mcer12/Flippity210/resources/boards.jpg

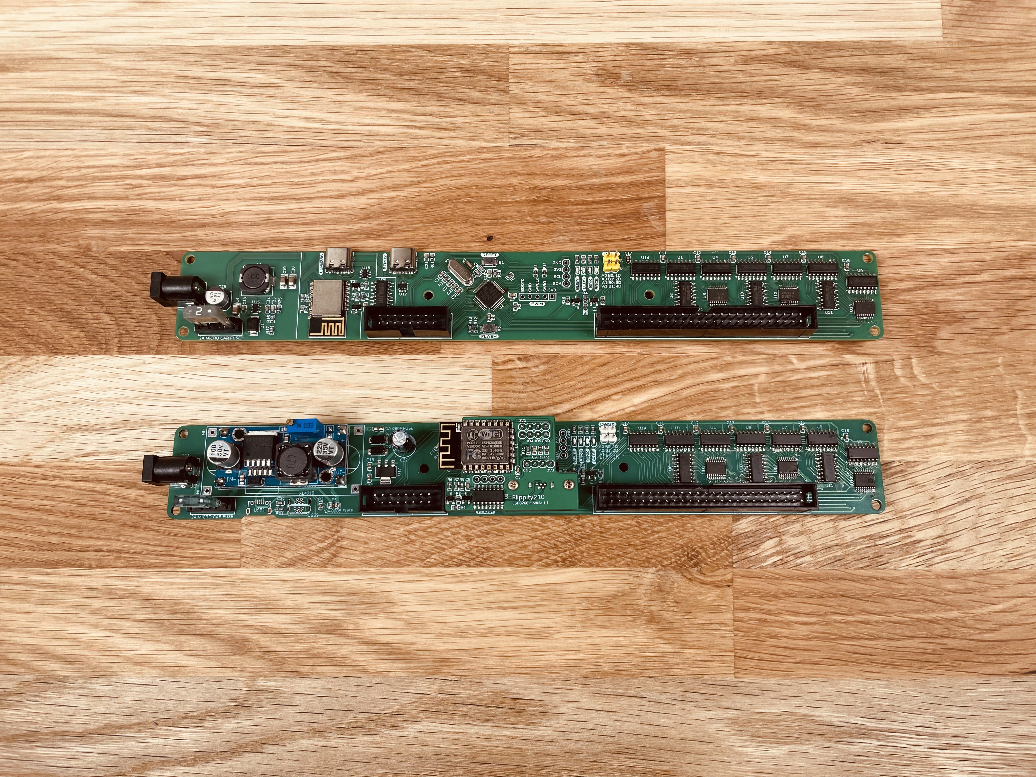
resources/boards.jpg
