mcer12/Flippity210/README.md

# Flippity210
Control board and library for BUSE BS210 flip dot displays. It also works with older BS110 (non-led) variant, just bear in mind that BS110 is a different form factor so it won't fit in the 3D printed enclosure!

https://github.com/user-attachments/assets/d0198746-1350-4b9b-a5e5-f4e7e80c436d

- This project enables you to control these beautiful flip-dot displays via I2C the same way you use I2C oled displays for example. 
- The library supports Adafruit GFX which enables you to draw fonts and geometry.
- Custom PCB and schematic is provided in the repository and replaces the original control board (it is not the same form factor!).
- The board has two MCUs - STM32 to control the display itself and provide a simple I2C interface to communicate with, and optional ESP8266 to control the STM32 via I2C on high level.
- I2C header if you don't want o use built-in ESP8266 and/or want to add other I2C devices.
- Supports up to 4 daisy-chained displays with the default firmware, up to 8 in theory with SW changes.

## What's needed to make it work:
- Assembled custom board (see repository wiki page and schematic notes)
- 24V adapter (see repository wiki)
- ST-Link and STM Cube Programmer to flash STM32 firmware to the board
- Arduino IDE or PlatformIO to flash the integrated ESP8266 or you can connect to the board via I2C from Raspberry or whatever else.
- See project wiki https://github.com/mcer12/Flippity210/wiki

## Status
- PCB: Finished! Latest V3X (and V3) revision has integrated ESP8266 so it doesn't require the daughter board anymore.
- Library: Finished
- 3D printed enclosure: https://www.printables.com/model/468031-flippity210-flip-dot-display-case

  

Photo 29 03 2025, 18 18 272
