mcer12/Flippity210/pcb/Flippity210_V3_schematic.pdf

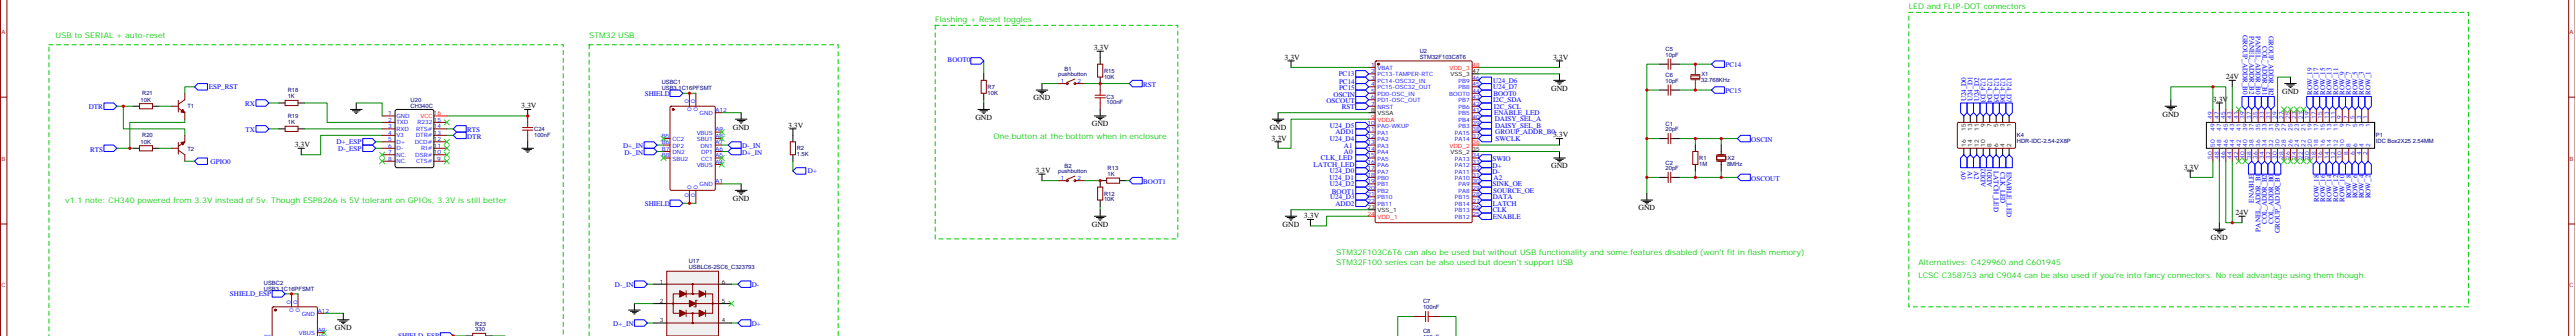
[picture p4: figure]
IDC Box2X25 2.54MM; HDR-IDC-2.54-2X8P; ADD2; ADD1; STM32F103C8T6; VBAT; PC13-TAMPER-RTC; PC14-OSC32_IN; PC15-OSC32_OUT; PD0-OSC_IN; PD1-OSC_OUT; NRST; VSSA; VDDA; PA0-WKUP; VSS_1; VDD_1; VSS_2; VDD_2; BOOT0; VSS_3; VDD_3; GND; GROUP_ADDR_B0 PANEL_ADDR_B2; PANEL_ADDR_B0 PANEL_ADDR_B1; ENABLE; COL_ADDR_B1; GROUP_ADDR_B2; COL_ADDR_B2; COL_ADDR_B0; GROUP_ADDR_B1; ROW_19; ROW_17; ROW_15; ROW_13; ROW_11 ROW_9; ROW_7; ROW_5; ROW_3; ROW_1; ROW_18; ROW_16; ROW_14; ROW_12; ROW_10 ROW_8; ROW_6; ROW_4; ROW_2; 32.768KHz; OSCOUT; OSCIN; OSCIN OSCOUT; SWIO; SWCLK; BOOT1; RST; LATCH_LED CLK_LED; DATA; CLK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
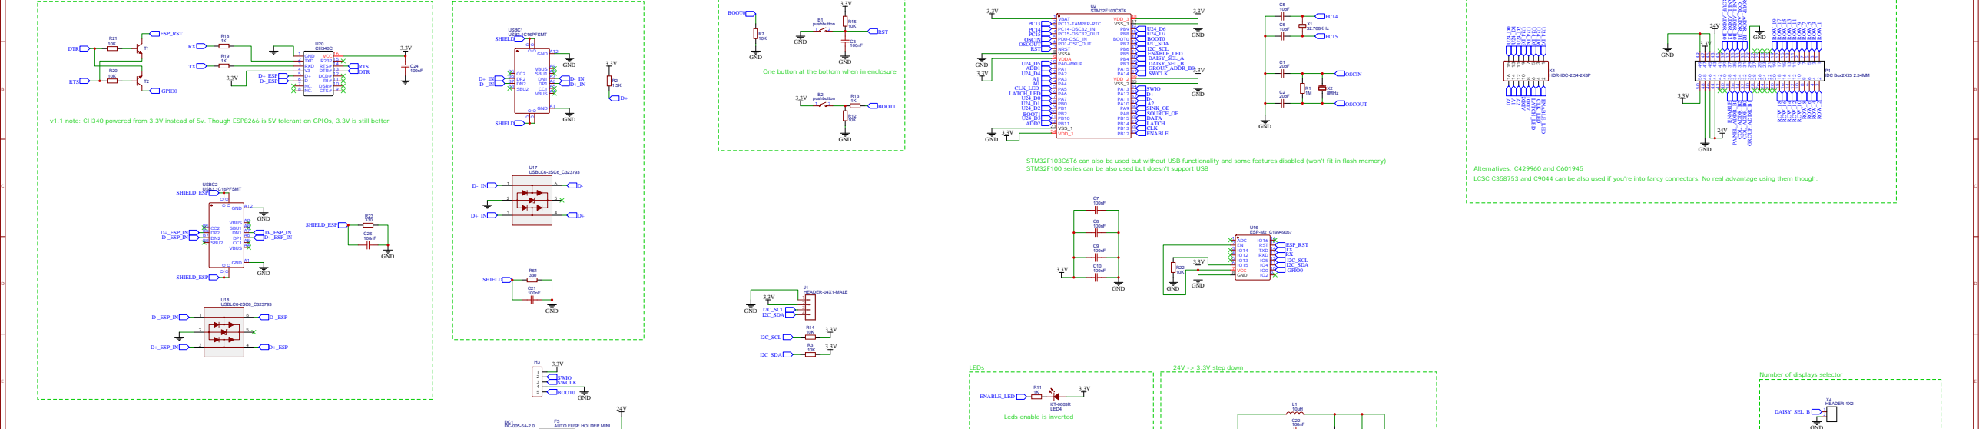
[picture p5: figure]
GND; SWCLK; SWIO; ENABLE_LED; KT-0603R LED4; BOOT0; HEADER-1X2; SHIELD; DAISY_SEL_B; Leds enable is inverted; LEDs; I2C_SCL I2C_SDA; HEADER-04X1-MALE; I2C_SDA; I2C_SCL; Number of displays selector; 24V -> 3.3V step down; ESP-M2_C19949057; ADC; VCC; RXD; TXD; RST; GPIO0; ESP_RST; GND GND; USBLC6-2SC6_C323793; D+_ESP_IN; D+_ESP; D-_ESP_IN; D-_ESP; SHIELD_ESP; CC2 B5 DP2 B6 DN2 B7 SBU2 B8; GND A1

F | F
G | G
H | H
I | I
J | J
K | K

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
TITLE:
Flippity Control Board | REV: 2.1
Date: | 2023-04-04

Sheet: 1/1
Drawn By: NiceThings

Company:

9 10 10 11 11 12 12 13 13 14 14 15 15 16 16 17 17 18 18 19 19 20 20 21 21 22 22 23 23 24 24 25 25 26 26 27 27 28 28 29 29 30 30 31 31 32 32 33 33 34 34 35 35 36 36 37 37 38 38 39 39 40 40 41 41 42 42 43 43 44 44 45 45 46 46 47 47 48 48 49 49 50 50

74HC595D,118

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
8 Q7S

9 MR# 10 SHCP 11 STCP 12 OE# 13 DS 14 Q0 15 VCC 16

74HC595D,118

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
8 Q7S

9 MR# 10 SHCP 11 STCP 12 OE# 13 DS 14 Q0 15 VCC 16

ULN2003ADR

U6

1B

1 2B

2 3B

3 4B

4 5B

5 6B

6 7B

7

E

8 COM

9

7C 10

6C 11

5C 12

4C 13

3C 14

2C 15

1C 16

74HC595D,118

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
8 Q7S

9 MR# 10 SHCP 11 STCP 12 OE# 13 DS 14 Q0 15 VCC 16

74HC595D,118

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
8 Q7S

9 MR# 10 SHCP 11 STCP 12 OE# 13 DS 14 Q0 15 VCC 16

74HC595D,118

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
8 Q7S

9 MR# 10 SHCP 11 STCP 12 OE# 13 DS 14 Q0 15 VCC 16

ULN2003ADR

U10

1B

1 2B

2 3B

3 4B

4 5B

5 6B

6 7B

7

E

8 COM

9

7C 10

6C 11

5C 12

4C 13

3C 14

2C 15

1C 16

ULN2003ADR

U11

1B

1 2B

2 3B

3 4B

4 5B

5 6B

6 7B

7

E

8 COM

9

7C 10

6C 11

5C 12

4C 13

3C 14

2C 15

1C 16

ROW_19

ROW_18
ROW_17

ROW_16
ROW_15

74HC595D,118

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
8 Q7S

# 9 MR# 10 SHCP 11 STCP 12 OE# 13 DS 14 Q0 15 VCC 16 ROW_19 ROW_18 ROW_17 ROW_16 ROW_15

ROW_4

TBD62783AFNG,EL

U3

I1

1 I2

2 I3

3 I4

4 I5

5 I6

6 I7

7 I8

8 VCC

9 GND 10

O8 11

O7 12

O6 13

O5 14

O4 15

O3 16

O2 17

O1 18

TBD62783AFNG,EL

U12

I1

1 I2

2 I3

3 I4

4 I5

5 I6

6 I7

7 I8

8 VCC

9 GND 10

O8 11

O7 12

O6 13

O5 14

O4 15

O3 16

O2 17

O1 18

TBD62783AFNG,EL

U13

I1

1 I2

2 I3

3 I4

4 I5

5 I6

6 I7

7 I8

8 VCC

9 GND 10

O8 11

O7 12

O6 13

O5 14

O4 15

O3 16

O2 17

O1 18

74HC595D,118

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
8 Q7S

9 MR# 10 SHCP 11 STCP 12 OE# 13 DS 14 Q0 15 VCC 16

KT-0603R

LED1

PC13

GND

DC-005-5A-2.0
1

2

3
3.3V

SINK_OE
BSS138

F8

GND GND

3.3V

SINK_OE_INVERTED | SOURCE_OE_INVERTED

3.3V

GND GND

BSS138

SOURCE_OE | F1

KT-0603R

LED2

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
ROW_11

GROUP_ADDR_B2

GROUP_ADDR_B1
COL_ADDR_B2
COL_ADDR_B1

COL_ADDR_B0

3.3V

GND

3.3V

GND

3.3V

GND

3.3V

GND

3.3V

GND

3.3V

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
3.3V

100nF

C11

100nF

C12

100nF

C13

100nF

C14

GND

100nF

C15

100nF

C16

100nF

C17

3.3V

GND

SINK_OE_INVERTED

SOURCE_OE_INVERTED
SINK_OE_INVERTED

SINK_OE_INVERTED

SOURCE_OE_INVERTED
SOURCE_OE_INVERTED

ROW_9

ROW_14
ROW_13

ROW_9

ROW_14
ROW_13

ROW_12
ROW_11

ROW_10

ROW_12
ROW_8

ROW_10
ROW_8

ROW_5

ROW_3

ROW_1
ROW_2

ROW_6

ROW_7

ROW_5

ROW_3

ROW_1
ROW_4

ROW_2

ROW_6

ROW_7

GND

3.3V
DATA

LATCH

CLK

LATCH

CLK

LATCH

CLK

LATCH

CLK

LATCH

CLK

LATCH

CLK

LATCH

CLK

3.3V | 3.3V
3.3V | 3.3V
3.3V | 3.3V

DATA2
DATA3

DATA4

DATA5

DATA6
DATA7

DATA5

DATA6
DATA7
DATA4

DATA3

DATA2

U6_7B
U6_6B

U6_5B

U6_1B

U6_2B

U6_3B

U6_4B

U5_7B

U5_6B

U5_5B

U5_1B

U5_2B
U5_3B

U5_4B

U8_7B

U8_6B

U8_5B

U8_1B

U8_2B

U8_3B

U8_4B

U6_7B

U6_6B

U6_5B

U6_4B

U6_3B

U6_2B

U6_1B

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
U5_7B

U5_6B

U5_5B

U5_4B

U5_3B
U5_2B

U5_1B

U8_7B

U8_6B

U8_5B

U8_4B

U8_3B

U8_2B

U8_1B

AUTO FUSE HOLDER MINI
2 | 1

HEADER-1X2

X3

1
2

GND

GND

1K

R6

PANEL_ADDR_B1

PANEL_ADDR_B0 PANEL_ADDR_B2

DAISY_SEL_A

SOURCE_OE_INVERTED

3.3V

KT-0603R

LED3

1K

R10
SINK_OE_INVERTED

3.3V

Sink + Source drivers

Older TD62783AFNG can be used (available on aliexpress)
HT62783ARTZ (lcsc: C5143073) can also be used BUT but has two extra pins so check the datasheet! Those pins are disconnected and will just lay on the solder mask

This part is critical, controls the electromagnets with high current surges, any solder bridge or interminnent connection can cause magic smoke!

STM32F103C6T6 can also be used but without USB functionality and some features disabled (won't fit in flash memory) STM32F100 series can be also used but doesn't support USB
LCSC C358753 and C9044 can be also used if you're into fancy connectors. No real advantage using them though.

For micro fuse use C843270 holder

Cheaper chinese 595 shift registers like C79097 also work perfectly fine

One button at the bottom when in enclosure

Use jumpers to switch number of displays in daisy-chain generic 2.54mm jumper will work, ie C5274534

1A fuse recommended, 2A max (C151091)

TPS54202DDCR

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
BOOT

6

10uF

C4
100nF

C18
22uF

C19
22uF

C20

GND

GND

GND

56pF

C23

3.3V

10K

R16

12k

R17

100K

R25

24V

SMBJ26A_C315992

D1

GND

v1.1 note: CH340 powered from 3.3V instead of 5v. Though ESP8266 is 5V tolerant on GPIOs, 3.3V is still better

VBUS A4 CC1 A5 DP1 A6 DN1 A7 SBU1 A8 VBUS A9

GND

100uF

C25
