mcer12/Flippity210/pcb/Flippity210_v2.1_schematic.pdf

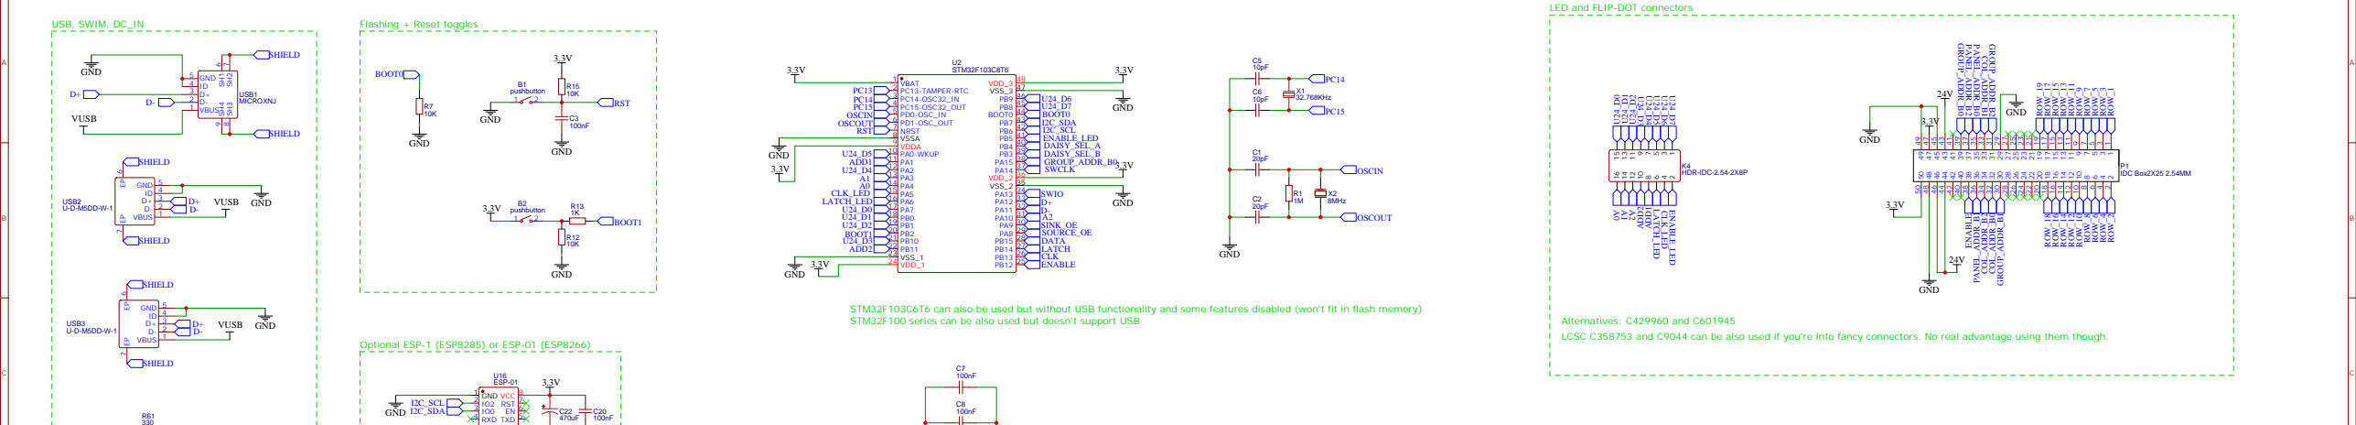
[picture p6: figure]
IDC Box2X25 2.54MM; HDR-IDC-2.54-2X8P; ADD2; ADD1; STM32F103C8T6; VBAT; PC13-TAMPER-RTC; PC14-OSC32_IN; PC15-OSC32_OUT; PD0-OSC_IN; PD1-OSC_OUT; NRST; VSSA; VDDA; PA0-WKUP; VSS_1; VDD_1; VSS_2; VDD_2; BOOT0; VSS_3; VDD_3; GND; GROUP_ADDR_B0 PANEL_ADDR_B2; PANEL_ADDR_B0 PANEL_ADDR_B1; ENABLE; COL_ADDR_B1; GROUP_ADDR_B2; COL_ADDR_B2; COL_ADDR_B0; GROUP_ADDR_B1; ROW_19; ROW_17; ROW_15; ROW_13; ROW_11 ROW_9; ROW_7; ROW_5; ROW_3; ROW_1; ROW_18; ROW_16; ROW_14; ROW_12; ROW_10 ROW_8; ROW_6; ROW_4; ROW_2; 32.768KHz; OSCOUT; OSCIN; MICROXNJ; USB1; 6 GND 5 ID 4 D+ 3 D- 2 VBUS 1; OSCIN OSCOUT; SWIO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
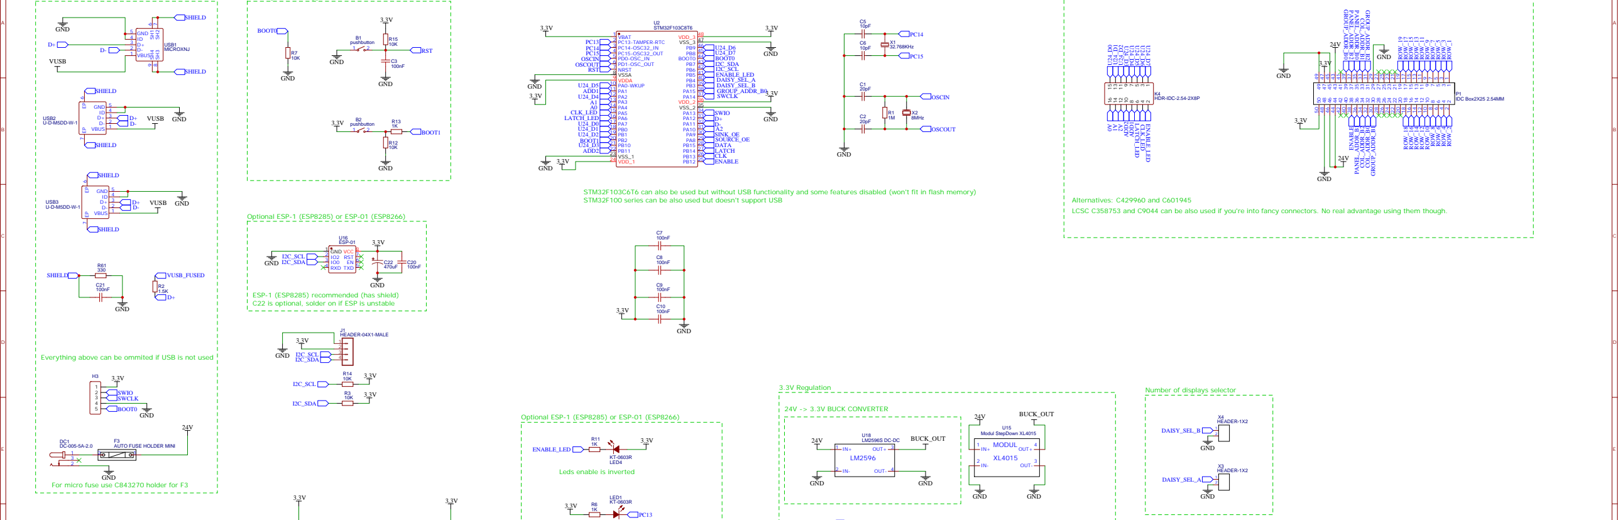
[picture p7: figure]
GND; SWCLK; SWIO; LED1; OUT+; OUT-; BUCK_OUT; 24V -> 3.3V BUCK CONVERTER; ENABLE_LED; KT-0603R LED4; 3.3V Regulation; BOOT0; AUTO FUSE HOLDER MINI; Modul StepDown XL4015; MODUL; TXD 5; RXD 4; ESP-1 (ESP8285) recommended (has shield); HEADER-1X2; SHIELD; DAISY_SEL_A; DAISY_SEL_B; VUSB_FUSED; Leds enable is inverted; I2C_SCL I2C_SDA; HEADER-04X1-MALE; I2C_SDA; I2C_SCL; Number of displays selector
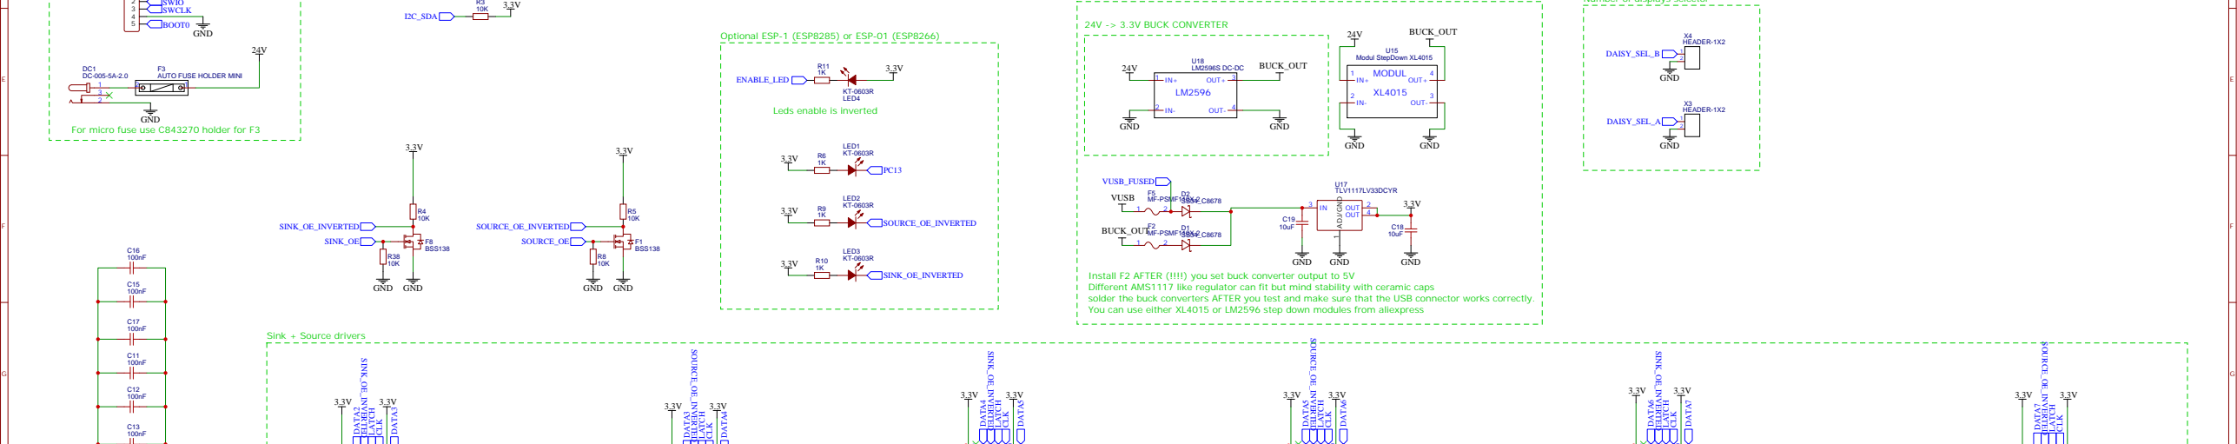
[picture p8: figure]
SINK_OE; BSS138; GND GND; SINK_OE_INVERTED; SOURCE_OE_INVERTED; SOURCE_OE; LED2; GND; VUSB; BUCK_OUT; MF-PSMF110X-2; LATCH; CLK; DATA2; DATA3; DATA4; DATA5; DATA6; DATA7; VUSB_FUSED; TLV1117LV33DCYR; U17ADJ/GND; OUT; LED3; Sink + Source drivers

H | H
I | I
J | J
K | K

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
TITLE:
Flipity V2 | REV: 1.0
Date: | 2020-11-14

Sheet: 1/1
Drawn By: NiceThings

Company:

9 10 10 11 11 12 12 13 13 14 14 15 15 16 16 17 17 18 18 19 19 20 20 21 21 22 22 23 23 24 24 25 25 26 26 27 27 28 28 29 29 30 30 31 31 32 32 33 33 34 34 35 35 36 36 37 37 38 38 39 39 40 40 41 41 42 42 43 43 44 44 45 45 46 46 47 47 48 48 49 49 50 50

74HC595D,118

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
8 Q7S

9 MR# 10 SHCP 11 STCP 12 OE# 13 DS 14 Q0 15 VCC 16

74HC595D,118

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
8 Q7S

9 MR# 10 SHCP 11 STCP 12 OE# 13 DS 14 Q0 15 VCC 16

ULN2003ADR

U6

1B

1 2B

2 3B

3 4B

4 5B

5 6B

6 7B

7

E

8 COM

9

7C 10

6C 11

5C 12

4C 13

3C 14

2C 15

1C 16

74HC595D,118

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
8 Q7S

9 MR# 10 SHCP 11 STCP 12 OE# 13 DS 14 Q0 15 VCC 16

74HC595D,118

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
8 Q7S

9 MR# 10 SHCP 11 STCP 12 OE# 13 DS 14 Q0 15 VCC 16

74HC595D,118

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
8 Q7S

9 MR# 10 SHCP 11 STCP 12 OE# 13 DS 14 Q0 15 VCC 16

ULN2003ADR

U10

1B

1 2B

2 3B

3 4B

4 5B

5 6B

6 7B

7

E

8 COM

9

7C 10

6C 11

5C 12

4C 13

3C 14

2C 15

1C 16

ULN2003ADR

U11

1B

1 2B

2 3B

3 4B

4 5B

5 6B

6 7B

7

E

8 COM

9

7C 10

6C 11

5C 12

4C 13

3C 14

2C 15

1C 16

ROW_19

ROW_18
ROW_17

ROW_16
ROW_15

74HC595D,118

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
8 Q7S

# 9 MR# 10 SHCP 11 STCP 12 OE# 13 DS 14 Q0 15 VCC 16 ROW_19 ROW_18 ROW_17 ROW_16 ROW_15

ROW_4

TBD62783AFNG,EL

U3

I1

1 I2

2 I3

3 I4

4 I5

5 I6

6 I7

7 I8

8 VCC

9 GND 10

O8 11

O7 12

O6 13

O5 14

O4 15

O3 16

O2 17

O1 18

TBD62783AFNG,EL

U12

I1

1 I2

2 I3

3 I4

4 I5

5 I6

6 I7

7 I8

8 VCC

9 GND 10

O8 11

O7 12

O6 13

O5 14

O4 15

O3 16

O2 17

O1 18

TBD62783AFNG,EL

U13

I1

1 I2

2 I3

3 I4

4 I5

5 I6

6 I7

7 I8

8 VCC

9 GND 10

O8 11

O7 12

O6 13

O5 14

O4 15

O3 16

O2 17

O1 18

74HC595D,118

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
8 Q7S

9 MR# 10 SHCP 11 STCP 12 OE# 13 DS 14 Q0 15 VCC 16

ROW_11

GROUP_ADDR_B2

GROUP_ADDR_B1
COL_ADDR_B2
COL_ADDR_B1

COL_ADDR_B0

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
3.3V
100nF

C14

GND

3.3V

GND

ROW_9

ROW_14
ROW_13

ROW_9

ROW_14
ROW_13

ROW_12
ROW_11

ROW_10

ROW_12
ROW_8

ROW_10
ROW_8

ROW_5

ROW_3

ROW_1
ROW_2

ROW_6

ROW_7

ROW_5

ROW_3

ROW_1
ROW_4

ROW_2

ROW_6

ROW_7

Different AMS1117 like regulator can fit but mind stability with ceramic caps

GND

3.3V
DATA

LATCH

CLK

DATA2

U6_7B
U6_6B

U6_5B

U6_1B

U6_2B

U6_3B

U6_4B

U5_7B

U5_6B

U5_5B

U5_1B

U5_2B
U5_3B

U5_4B

U8_7B

U8_6B

U8_5B

U8_1B

U8_2B

U8_3B

U8_4B

U6_7B

U6_6B

U6_5B

U6_4B

U6_3B

U6_2B

U6_1B

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
U5_7B

U5_6B

U5_5B

U5_4B

U5_3B
U5_2B

U5_1B

U8_7B

U8_6B

U8_5B

U8_4B

U8_3B

U8_2B

U8_1B

Optional ESP-1 (ESP8285) or ESP-01 (ESP8266)

PANEL_ADDR_B1

PANEL_ADDR_B0 PANEL_ADDR_B2

Optional ESP-1 (ESP8285) or ESP-01 (ESP8266)

C22 is optional, solder on if ESP is unstable

Install F2 AFTER (!!!!) you set buck converter output to 5V

Everything above can be ommited if USB is not used

Older TD62783AFNG can be used (available on aliexpress)
HT62783ARTZ (lcsc: C5143073) can also be used BUT but has two extra pins so check the datasheet! Those pins are disconnected and will just lay on the solder mask

This part is critical, controls the electromagnets with high current surges, any solder bridge or interminnent connection can cause magic smoke!

solder the buck converters AFTER you test and make sure that the USB connector works correctly.

STM32F103C6T6 can also be used but without USB functionality and some features disabled (won't fit in flash memory) STM32F100 series can be also used but doesn't support USB

You can use either XL4015 or LM2596 step down modules from aliexpress

LCSC C358753 and C9044 can be also used if you're into fancy connectors. No real advantage using them though.

For micro fuse use C843270 holder for F3

Cheaper chinese 595 shift registers like C79097 also work perfectly fine
