mcer12/Flippity210/pcb/Flippity210_v2.1_BOM.csv

ID | Name | Designator | Footprint | Quantity | Manufacturer Part | Manufacturer | Supplier | Supplier Part | Price
1 | pushbutton | B1,B2,B3 | SW-SMD_L3.9-W3.0-P4.45 | 3 | TS-1088R-02026 | XUNPU | LCSC | C455280 | 0.008
2 | 20pF | C1,C2 | C0603 | 2 | CL10C200JB8NNNC | SAMSUNG(三星) | LCSC | C1648 | 0.001
3 | 100nF | C3,C7,C8,C9,C10,C11,C12,C13,C14,C15,C16,C17,C20,C21 | C0603 | 14 | CC0603KRX7R9BB104 | YAGEO | LCSC | C14663
4 | 10pF | C5,C6 | C0603 | 2 | CL10C100JB8NNNC | SAMSUNG(三星) | LCSC | C1634 | 0.001
5 | 10uF | C18,C19 | C0603 | 2 | CL10A106KP8NNNC | SAMSUNG | LCSC | C19702 | 0.001
6 | 470uF | C22 | CAP-TH_BD8.0-P3.50-D0.6-FD_1 | 1 | EKY-100ETD471MHB5D | NCC(日本贵弥功) | LCSC | C355285 | 0.022
7 | SS34_C8678 | D1,D2 | DO-214AC_L4.3-W2.7-LS5.3-RD | 2 | SS34 | MDD | LCSC | C8678 | 0.005
8 | DC-005-5A-2.0 | DC1 | DC-IN-TH_DC-005-5A-2.0 | 1 | DC-005-5A-2.0 | XKB Enterprise | LCSC | C381116 | 0.035
9 | BSS138 | F1,F8 | SOT-23-3_L2.9-W1.3-P1.90-LS2.4-BR | 2 | BSS138 | CJ | LCSC | C78284 | 0.004
10 | MF-PSMF110X-2 | F2,F5 | F0805 | 2 | MF-PSMF110X-2 | BOURNS | LCSC | C89658 | 0.005
11 | AUTO FUSE HOLDER MINI | F3 | AUTO FUSE HODER MINI | 1 | BX505-33 | DEALON | LCSC | C2935870 | 0.026
12 | Header-Female-2.54_1x5 | H3 | HDR-TH_5P-P2.54-V-F | 1 | 2.54-1*5P母 | BOOMELE(博穆精密) | LCSC | C50950 | 0.01
13 | HEADER-04X1-MALE | J1 | PINHEADER_04X1_MALE | 1
14 | HDR-IDC-2.54-2X8P | K4 | IDC-TH_16P-P2.54_C3406 | 1 | 2.54-2*8P简牛 | BOOMELE(博穆精密) | LCSC | C3406 | 0.015
15 | KT-0603R | LED1,LED2,LED3,LED4 | LED0603-R-RD | 4 | KT-0603R | KENTO | LCSC | C2286
16 | IDC Box2X25 2.54MM | P1 | IDC-TH_50P-P2.54_BOOMELE2X25P | 1 | 2.54-2*25P简牛 | BOOMELE(博穆精密) | LCSC | C30006 | 0.031
17 | 1M | R1 | R0603 | 1 | 0603WAF1004T5E | UniOhm | LCSC | C22935
18 | 1.5K | R2 | R0603 | 1 | 0603WAF1501T5E | UNI-ROYAL(厚声) | LCSC | C22843
19 | 10K | R3,R4,R5,R7,R8,R12,R14,R15,R38 | R0603 | 9 | 0603WAF1002T5E | UNI-ROYAL(厚声) | LCSC | C25804
20 | 1K | R6,R9,R10,R11,R13 | R0603 | 5 | 0603WAF1001T5E | UNI-ROYAL(厚声) | LCSC | C21190
21 | 330Ω | R61 | R0603 | 1 | 0603WAF3300T5E | UniOhm | LCSC | C23138
22 | 10kΩ | RN3,RN4,RN5,RN6,RN7,RN8 | RES-ARRAY-SMD_0603-8P-L3.2-W1.6-BL | 6 | 4D03WGJ0103T5E | UNI-ROYAL(厚声) | LCSC | C29718 | 0.001
23 | 74HC595D,118 | U1,U4,U5,U7,U8,U9,U14 | SOIC-16_L9.9-W3.9-P1.27-LS6.0-BL | 7 | 74HC595D,118 | Nexperia(安世) | LCSC | C5947 | 0.031
24 | STM32F103C8T6 | U2 | LQFP-48_L7.0-W7.0-P0.50-LS9.0-BL | 1 | STM32F103C8T6 | ST(意法半导体) | LCSC | C8734 | 0.384
25 | TBD62783AFNG,EL | U3,U12,U13 | SSOP-18_L6.8-W4.4-P0.65-LS6.4-BL | 3 | TBD62783AFNG,EL | TOSHIBA(东芝) | LCSC | C2653777 | 0.459
26 | ULN2003ADR | U6,U10,U11 | SOIC-16_L9.9-W3.9-P1.27-LS6.0-BL | 3 | ULN2003ADR | TI(德州仪器) | LCSC | C7512 | 0.027
27 | Modul StepDown XL4015 | U15 | XL4015-5A-MODULE | 1
28 | ESP-01 | U16 | WIFIM-TH_8P-L24.7-W14.4-P2.54 | 1 | ESP-01 | Ai-Thinker(安信可) | LCSC | C503581 | 0.351
29 | TLV1117LV33DCYR | U17 | SOT-223_L6.7-W3.5-P2.30-BR | 1 | TLV1117LV33DCYR | TI(德州仪器) | LCSC | C15578 | 0.036
30 | LM2596S DC-DC | U18 | LM2596S | 1
31 | MICROXNJ | USB1 | MICRO-USB-SMD_MICROXNJ | 1 | MicroXNJ | SHOU HAN | LCSC | C404969 | 0.006
32 | U-D-M5DD-W-1 | USB2,USB3 | MICRO-USB-TH_MICRO-USB-A14 | 2 | U-D-M5DD-W-1 | HRO | LCSC | C145795 | 0.029
33 | 32.768KHz | X1 | FC-135R_L3.2-W1.5 | 1 | Q13FC1350000400 | EPSON | LCSC | C32346 | 0.033
34 | 8MHz | X2 | HC-49S | 1 | HC-49S 8MHz 20pF 30PPM | TAE | LCSC | C107425 | 0.011
35 | HEADER-1X2 | X3,X4 | HEADER-1X2-2.54 | 2 |  |  | Mouser | undefined
