mcer12/Flippity210/(threads)

Thread 1 (2023-03-16):

STM firmware

Cbuijse, 2023-03-16:
Hi,

I believe the map display fw/Flippity210_fw/ contains the STM32 softwware?

Which part of that should be flashed on the ST to make it work and where is the cube programmer file if there is one?

mcer12, 2023-03-16:
You open it in arduino IDE and flash via your prefered method. In the wiki you can find suggestion to first flash the HID bootloader for easier flashing but since you'll probably only flash it once, you can skip bootloader burning and just flash it via SWD.

mcer12, 2023-03-16:
Those files are tabs in arduino ide :) you open the main file Flippity210_fw.ino

Cbuijse, 2023-03-16:
Alright thanks.

Thread 2 (2024-11-13):

Can you please add schematics source files?

machuvla, 2024-11-13:
Can you please publish PCB schematics in editable format to allow for PCB tunning?

Thanks.

mcer12, 2024-11-13:
It's a little difficult as I was making this in easyeda. Try these files if you're able to import them to easyeda and let me know. If they work, I'll add them to the repo.
[Flippity_SCH.json](https://github.com/user-attachments/files/17740311/Flippity_SCH.json)
[Flippity_PCB.json](https://github.com/user-attachments/files/17740312/Flippity_PCB.json)
[Flippity_ESP_MODULE_SCH.json.json](https://github.com/user-attachments/files/17740315/Flippity_ESP_MODULE_SCH.json.json)
[Flippity_ESP_MODULE_PCB.json](https://github.com/user-attachments/files/17740316/Flippity_ESP_MODULE_PCB.json)

machuvla, 2024-11-14:
Nice. Thanks. I will share the mods when tested.

mcer12, 2025-01-07:
do you have any outputs yet? What changes do you have in mind?
