mcer12/Flippity210/display fw/Flippity210_fw/font.ino

/*
uint8_t digitsLargeRound[10][9][5] = {
  {
    {0, 1, 1, 1, 0},
    {1, 0, 0, 0, 1},
    {1, 0, 0, 0, 1},
    {1, 0, 0, 0, 1},
    {1, 0, 0, 0, 1},
    {1, 0, 0, 0, 1},
    {1, 0, 0, 0, 1},
    {1, 0, 0, 0, 1},
    {0, 1, 1, 1, 0},
  },
  {
    {0, 0, 1, 0, 0},
    {0, 0, 1, 0, 0},
    {0, 1, 1, 0, 0},
    {0, 0, 1, 0, 0},
    {0, 0, 1, 0, 0},
    {0, 0, 1, 0, 0},
    {0, 0, 1, 0, 0},
    {0, 0, 1, 0, 0},
    {0, 1, 1, 1, 0},
  },
  {
    {0, 1, 1, 1, 0},
    {1, 0, 0, 0, 1},
    {0, 0, 0, 0, 1},
    {0, 0, 0, 0, 1},
    {0, 0, 0, 1, 0},
    {0, 0, 1, 0, 0},
    {0, 1, 0, 0, 0},
    {1, 0, 0, 0, 0},
    {1, 1, 1, 1, 1},
  },
  {
    {0, 1, 1, 1, 0},
    {1, 0, 0, 0, 1},
    {0, 0, 0, 0, 1},
    {0, 0, 0, 0, 1},
    {0, 1, 1, 1, 0},
    {0, 0, 0, 0, 1},
    {0, 0, 0, 0, 1},
    {1, 0, 0, 0, 1},
    {0, 1, 1, 1, 0},
  },
  {
    {1, 0, 0, 0, 1},
    {1, 0, 0, 0, 1},
    {1, 0, 0, 0, 1},
    {1, 0, 0, 0, 1},
    {0, 1, 1, 1, 1},
    {0, 0, 0, 0, 1},
    {0, 0, 0, 0, 1},
    {0, 0, 0, 0, 1},
    {0, 0, 0, 0, 1},
  },
  {
    {1, 1, 1, 1, 1},
    {1, 0, 0, 0, 0},
    {1, 0, 0, 0, 0},
    {1, 1, 1, 1, 0},
    {0, 0, 0, 0, 1},
    {0, 0, 0, 0, 1},
    {0, 0, 0, 0, 1},
    {1, 0, 0, 0, 1},
    {0, 1, 1, 1, 0},
  },
  {
    {0, 1, 1, 1, 0},
    {1, 0, 0, 0, 1},
    {1, 0, 0, 0, 0},
    {1, 0, 0, 0, 0},
    {1, 1, 1, 1, 0},
    {1, 0, 0, 0, 1},
    {1, 0, 0, 0, 1},
    {1, 0, 0, 0, 1},
    {0, 1, 1, 1, 0},
  },
  {
    {1, 1, 1, 1, 1},
    {0, 0, 0, 0, 1},
    {0, 0, 0, 0, 1},
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
    {0, 0, 1, 0, 0},
    {0, 0, 1, 0, 0},
    {0, 0, 1, 0, 0},
    {0, 0, 1, 0, 0},
  },
  {
    {1, 1, 1, 1, 1},
    {0, 0, 0, 0, 1},
    {0, 0, 0, 0, 1},
    {0, 0, 0, 1, 0},
    {0, 0, 1, 0, 0},
    {0, 1, 0, 0, 0},
    {1, 0, 0, 0, 0},
    {1, 0, 0, 0, 0},
    {1, 1, 1, 1, 1},
  },
};
*/
