mcer12/Flippity210/(commit log)

2023-02-18 initial firmware for board V1
2023-03-15 fw update for pcb v2
2023-03-15 gerber, schematic
2023-03-29 Board FW: added LEDs brightness toggle, fixed LEDs enable toggle + some minor edits
2023-03-29 Board FW: fixed animation speed setting
2023-04-04 PCB files v2.1 added
2023-04-04 Board fw optimizations for STM32F103C6T6
2023-04-04 ESP8266 daughter board files
2023-04-04 BOM added for pcbs
2023-05-14 little delay added to board fw for ESP-01 to have some time to boot up
2025-03-30 V3 board + minor fw edits
2025-11-09 Update README with detailed PCB and MCU information
    Clarify details about the custom PCB and its components.
2025-11-09 Added video and image of the boards
2026-09-13 V3.1 firmware - full functionality on STM32F103C6, added extra slow animation speed option, uses internal oscillator by default
2026-09-13 V3X board source files
